dereyurtali/single-axis-shaker-rig/photos/README.md

# Photographs

The stage mid-build. At the point these were taken the bearings had just gone on: the
belt, the printed table, the printer brackets and the printer itself are not fitted yet.

| File | What it shows |
|---|---|
| `rig-overview.jpg` | The whole stage on the bench, with driver and supply alongside |
| `rig-side.jpg` | Side view: frame, both rails, carriage bearings |
| `frame-and-rails-top.jpg` | From above — rail spacing, bearing positions, motor and idler ends |
| `electronics.jpg` | DM542 driver, Arduino Nano on its terminal shield, 48 V supply, DIP bank |
| `motor-label.jpg` | The motor's own label, claiming 2.2 N·m against a datasheet 1.6 N·m |
| `dial-indicator.jpg` | Indicator on a magnetic base — how the stroke and backlash tests are read |
| `stroke-caliper.jpg` | Caliper across the stage for the coarse commanded-vs-measured check |

EXIF metadata has been stripped from all of them.
