dereyurtali/single-axis-shaker-rig/hardware/cad/README.md

# CAD views

Renders of the full assembly — the shaker stage with the printer mounted on it — as drawn
before the build.

| File | View |
|---|---|
| `cad-assembly-iso.png` | Isometric, whole assembly |
| `cad-front.png` | Front elevation — printer on the carriage, stage underneath |
| `cad-left.png` | Left elevation — carriage, bearing blocks, motor and pulley |
| `cad-bottom.png` | From below — rail and bearing layout under the table |

These are renders, not the source model. The dimensions that matter are stated in the
[bill of materials](../../docs/bill-of-materials.md) and the
[design rationale](../../docs/design-rationale.md).
