dereyurtali/single-axis-shaker-rig/hardware/cad/cad-bottom.png

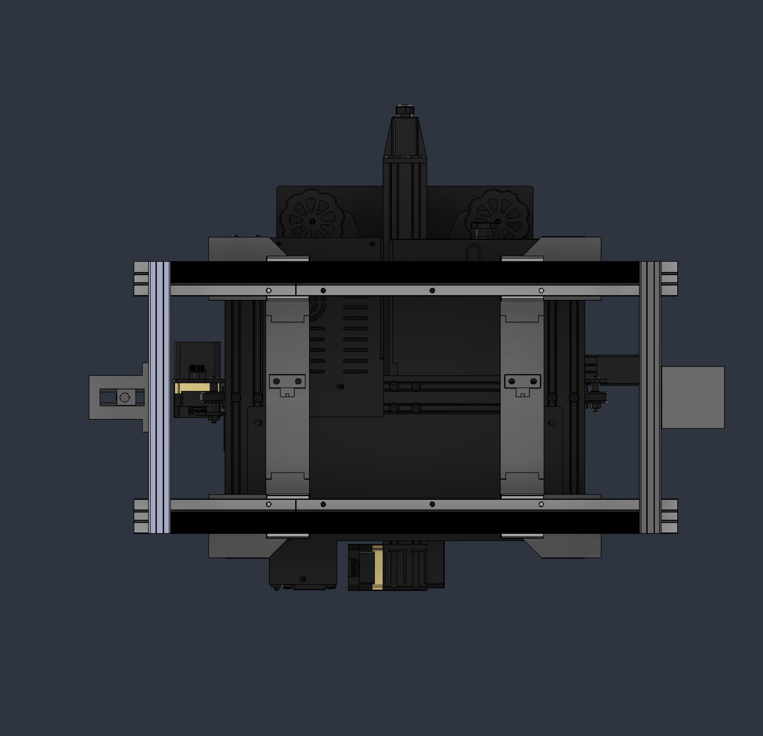
hardware/cad/cad-bottom.png
