dereyurtali/single-axis-shaker-rig/hardware/cad/cad-front.png

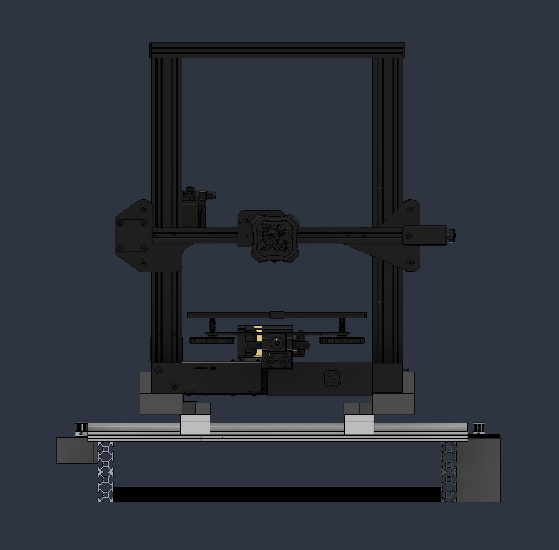
hardware/cad/cad-front.png
