dereyurtali/single-axis-shaker-rig/hardware/cad/cad-left.png

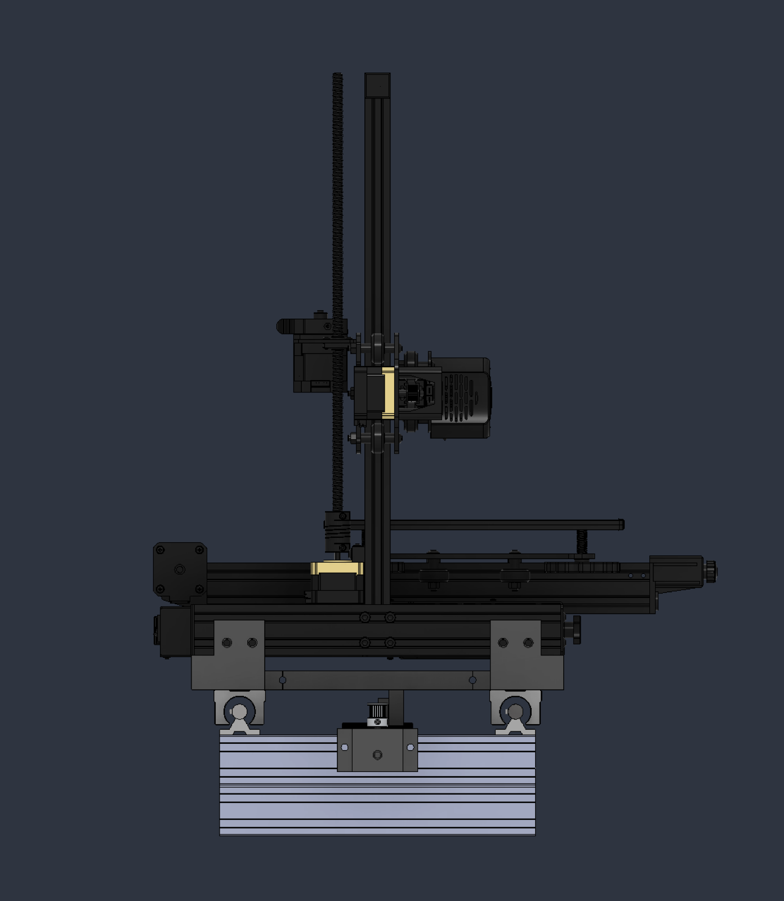
hardware/cad/cad-left.png
