dereyurtali/single-axis-shaker-rig/docs/bill-of-materials.md

# Bill of materials

What was actually ordered and built, not an idealised list. Suppliers are Turkish because
that is where it was built; the specification column is what matters if you source it
elsewhere.

Total: **under 200 USD** excluding the printer, the host PC and metrology.

Parts marked **own design** were designed for this rig and 3D printed; their CAD will be
added to [`hardware/cad/`](../hardware/cad/).

## Drive

| # | Part | Qty | Specification that matters |
|---|---|---|---|
| 1 | Stepper motor, NEMA 23 | 1 | **57HB84-154** · 84 mm body · 1.8° · 1.5 A/phase · 5.0 Ω · **10 mH/phase** · 1.6 N·m holding (datasheet, not the listing — see [design rationale §4](design-rationale.md#4-verifying-the-motor-against-its-datasheet)) · Ø8 mm shaft |
| 2 | Stepper driver | 1 | **DM542**, 4.5 A capable, STEP/DIR, optoisolated inputs. A TB6600 also works; **a TMC2209 does not** — it cannot supply this motor's current |
| 3 | Power supply | 1 | **Meanwell LRS-150-48**, 48 V / 3.3 A, enclosed. 48 V is required, not preference — [§6](design-rationale.md#6-why-48-v) |
| 4 | Microcontroller | 1 | **Arduino Nano**, ATmega328P, CH340, USB-C |
| 5 | Nano screw-terminal shield | 1 | Saves soldering; any equivalent breakout works |

## Motion

| # | Part | Qty | Specification that matters |
|---|---|---|---|
| 6 | GT2 belt, open-ended | 2 m ordered | **10 mm wide, steel cord.** 6 mm stretches more than one microstep under this load — [§5](design-rationale.md#5-belt-width-is-a-design-variable-not-a-constant) |
| 7 | GT2 pulley, 20 teeth | 1 | Ø8 mm bore (match your motor shaft), **flanged**, two grub screws. 40 mm/rev → 12.5 µm/step. Buy a 16-tooth as well if you may need more amplitude |
| 8 | GT2 idler, 20 teeth | 1 | **Toothed and on a bearing.** The belt wraps it teeth-inwards; a flat idler lets it walk |
| 9 | Supported linear rail, Ø12 mm | 2 × 500 mm | Induction-hardened, with the aluminium support rail. Ø12 rather than Ø8 because of the printer's mass and the 500 mm span |
| 10 | Linear bearing, SBR12UU | 4 | Ball bearings. **Not plastic bushings** — the friction eats the motor's margin |
| 11 | Belt clamp | 2 | 3D printed, **own design**. Fastened to the table with the only M3 bolts on the rig |
| 12 | Belt tensioner | 1 | 3D printed, **own design**. Carries the idler and slides it along the belt line to set preload |

## Structure

| # | Part | Qty | Specification that matters |
|---|---|---|---|
| 13 | 20×20 V-slot extrusion, slot 6 | 2 × 430 mm | Frame |
| 14 | 20×80 extrusion, slot 6 | 2 × 250 mm | Cross members / rail supports |
| 15 | Bearing-to-printer adapters | 4 | 3D printed ABS, 15 mm, **own design**. They bolt each SBR12UU straight to the Ender-3's own extrusion. There is no table — [§9](design-rationale.md#9-the-printers-frame-is-the-carriage) |
| 16 | Wide corner bracket, 20×25, slot 6 | 4 | Wide type, not the hidden internal connector — it carries the moment from the printer's mass |
| 17 | T-slot nuts, slot 6, M5 | as needed | Count not recorded during the build |
| 18 | M5 socket-head bolts, DIN 912 | assortment | Everything on the rig is M5 except the belt clamps. Lengths were picked as the build went; a 411-piece assortment covered it |
| 19 | M3 socket-head bolts | 4 | Belt clamps only — the sole M3 fasteners on the rig |

## 3D-printed parts

All printed in **ABS**, all designed for this rig. **Not PLA** for anything structural — it
creeps and fatigues under continuous vibration.

| Part | Qty | How it was printed |
|---|---|---|
| Motor mount | 2 pieces | **100 % infill** — it holds the only part of the rig that is deliberately shaking |
| Belt tensioner | 1 | 0.4 mm nozzle, 4 perimeters, 40 % infill |
| Bearing-to-printer adapters | 4 | 0.6 mm nozzle, 4 perimeters, 70 % infill, 15 mm thick. These carry the printer's 7.8 kg and are the whole load path between bearing and printer |
| Belt clamps | 2 | M3 — the only M3 fasteners on the rig |

Still to make: accelerometer mounts (rigid — a loose mount invents resonances that are not
there) and hard-stop blocks, 2 mm outside the software limit.

## Instrumentation (optional — needed to *characterise* the rig, not to run it)

| # | Part | Qty | Note |
|---|---|---|---|
| 20 | ADXL345 accelerometer breakout | 2–3 | One under the table (proof of what the shaker actually applied), one on whatever you are testing. A third, mounted alongside the first, gives you an honest upper bound on your own measurement uncertainty |
| 21 | Digital dial indicator, 1 µm, with data output | 1 | Stroke verification. In this band it is **better than an accelerometer** |
| 22 | Magnetic indicator base | 1 | |

## Suppliers used

GT2 belt and idler — rhino3dprinter · motor, pulley, Nano and shield — motorobit · driver —
robolinkmarket · rail and extrusion — mermakcnc, otomasyoncu · linear bearings —
sahinrulman · PSU — kartalotomasyon · T-nuts — ileri3d. Everything else was printed here.

## What we would change

- A printer with a **stationary bed**. The Ender-3's own Y axis pushes back against the
  shaker table during a print.
- Order the 16-tooth pulley at the same time as the 20-tooth. It is cheap, and it is the
  only lever you have if you need more amplitude later.
- Count the fasteners while building. The M5 bolt lengths and T-nut count were never
  written down, so this list cannot tell you how many of each to buy.
