dereyurtali/single-axis-shaker-rig/(commit log)

2026-08-20 Add self-contained example waveforms and point the tests at them
    [acceleration_example.csv, displacement_example.csv]
2026-08-20 Add build photographs and CAD views
2026-08-20 Correct the BOM against the real build: printed table and tensioner, own designs, fastener reality, cost
2026-08-20 Correct the load path: the printer's frame is the carriage, no table plate
